zhangxuhong1024/wifi2can/hardware/out/wifi2can.pdf

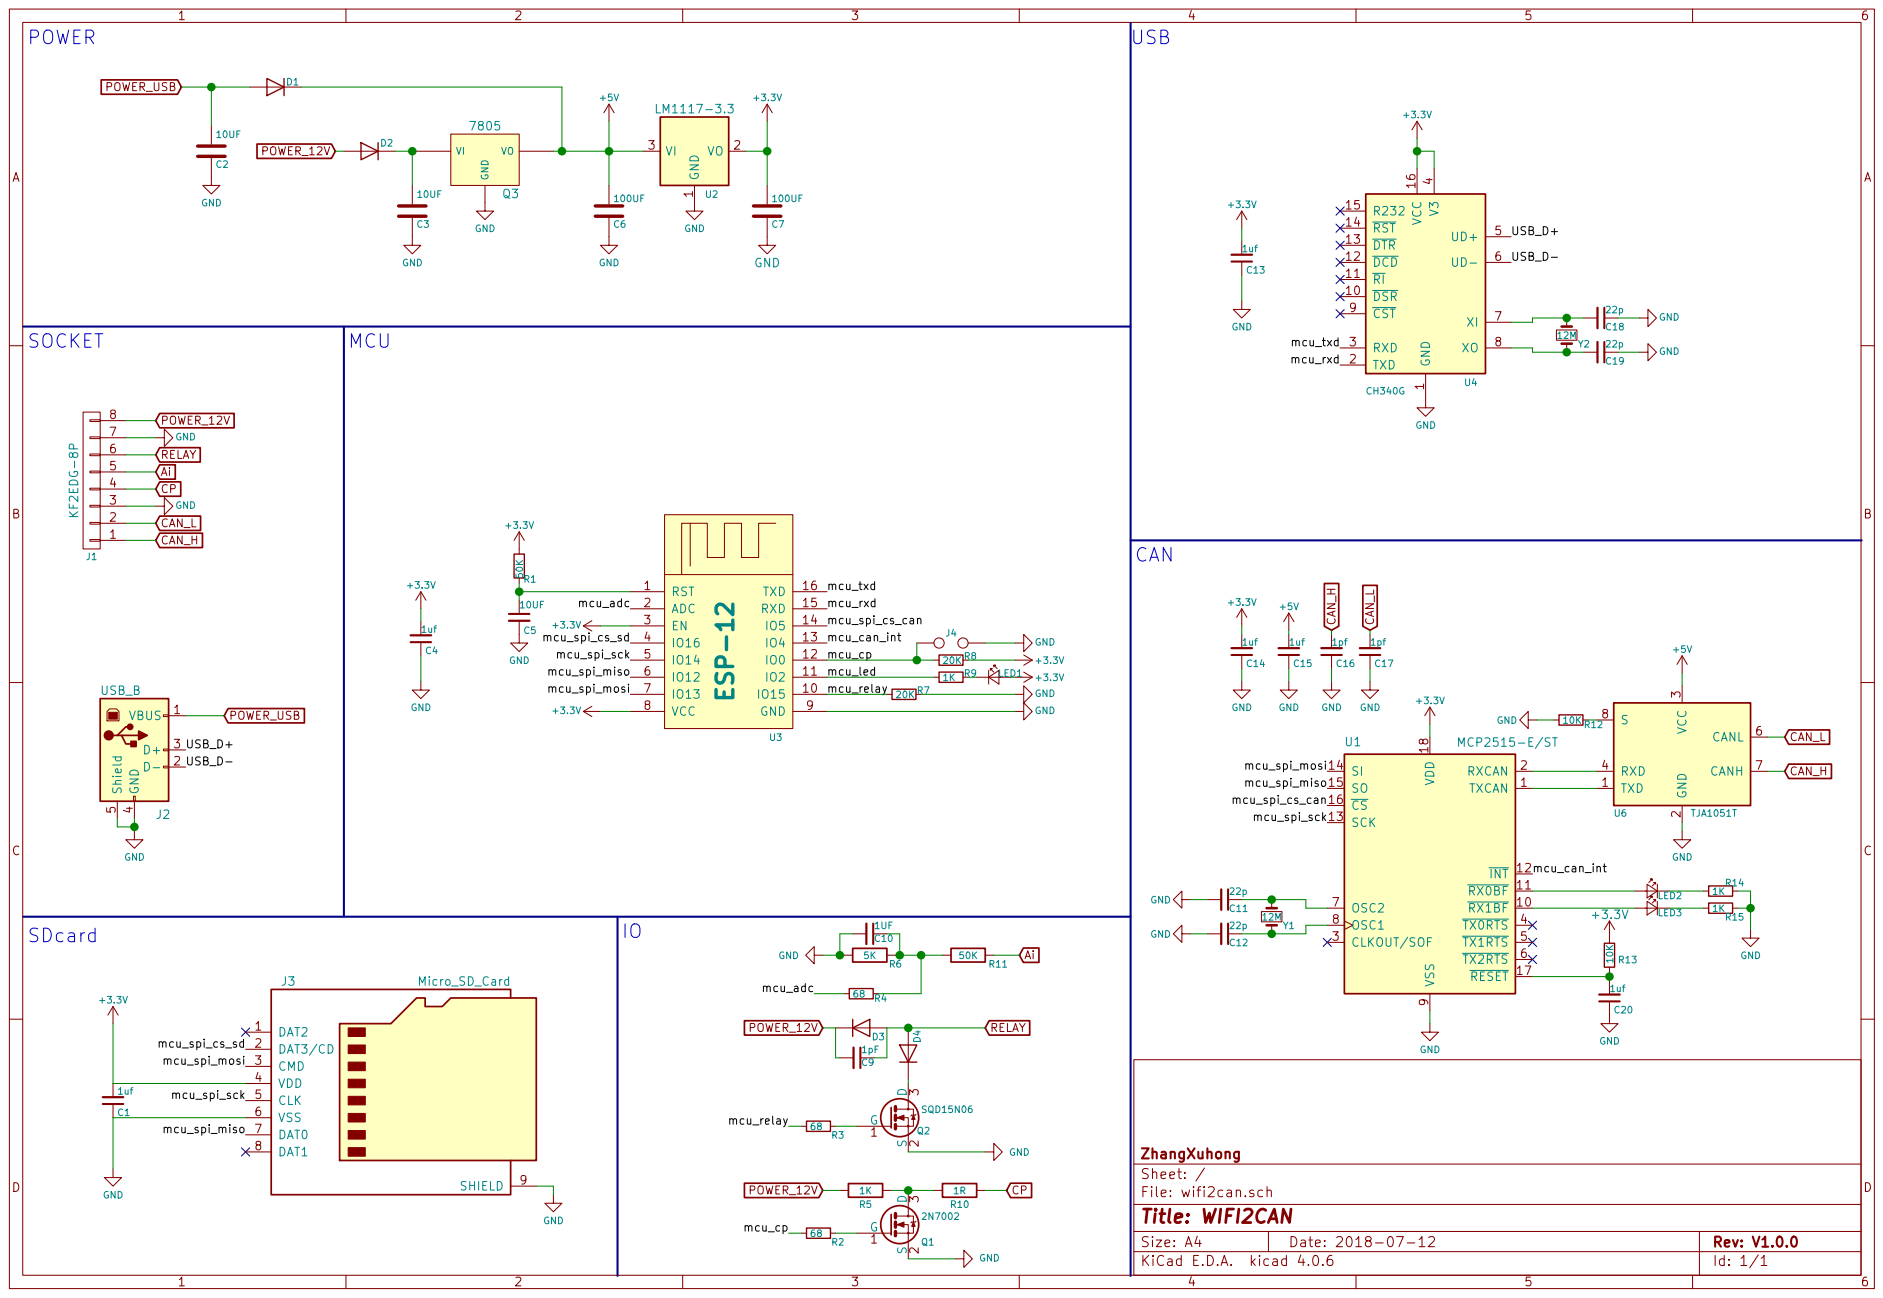
[picture p1: page 1]

1 VO 2 VI 3 U2 LM1117-3.3 RST 1 ADC 2 EN 3

4 UD+ 5 UD- 6 XI 7 XO 8 CST 9 DSR 10 RI 11 DCD 12 DTR 13 RST 14 R232 15 VCC 16 U4 CH340G GND

File: wifi2can.sch Sheet: / ZhangXuhong
