zhangxuhong1024/wifi2can/doc/外壳.pdf

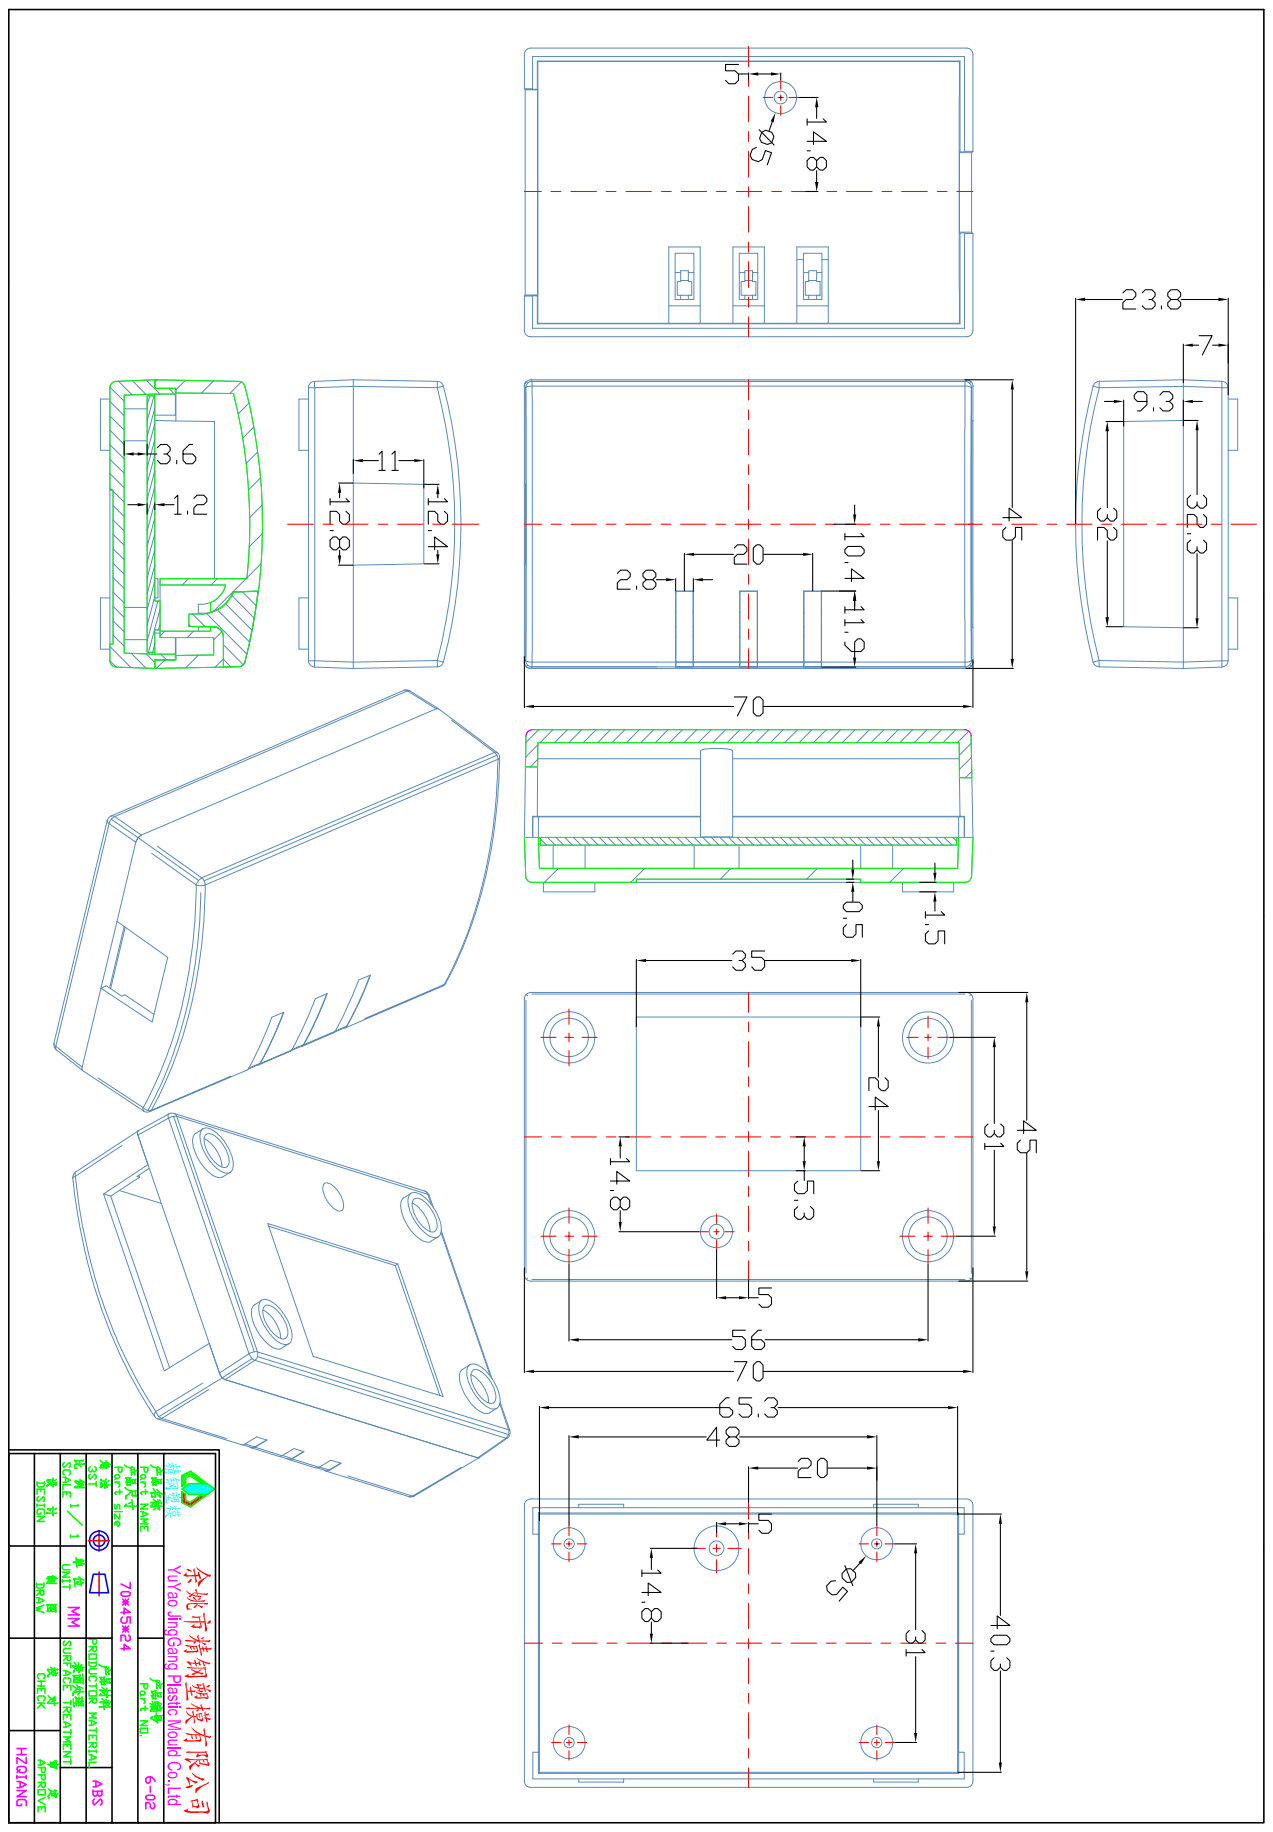
[picture p2: page 1]
