zhangxuhong1024/wifi2can/hardware/wifi2can.kicad_pcb

## KiCad design hardware/wifi2can.kicad_pcb (2018-11-23)

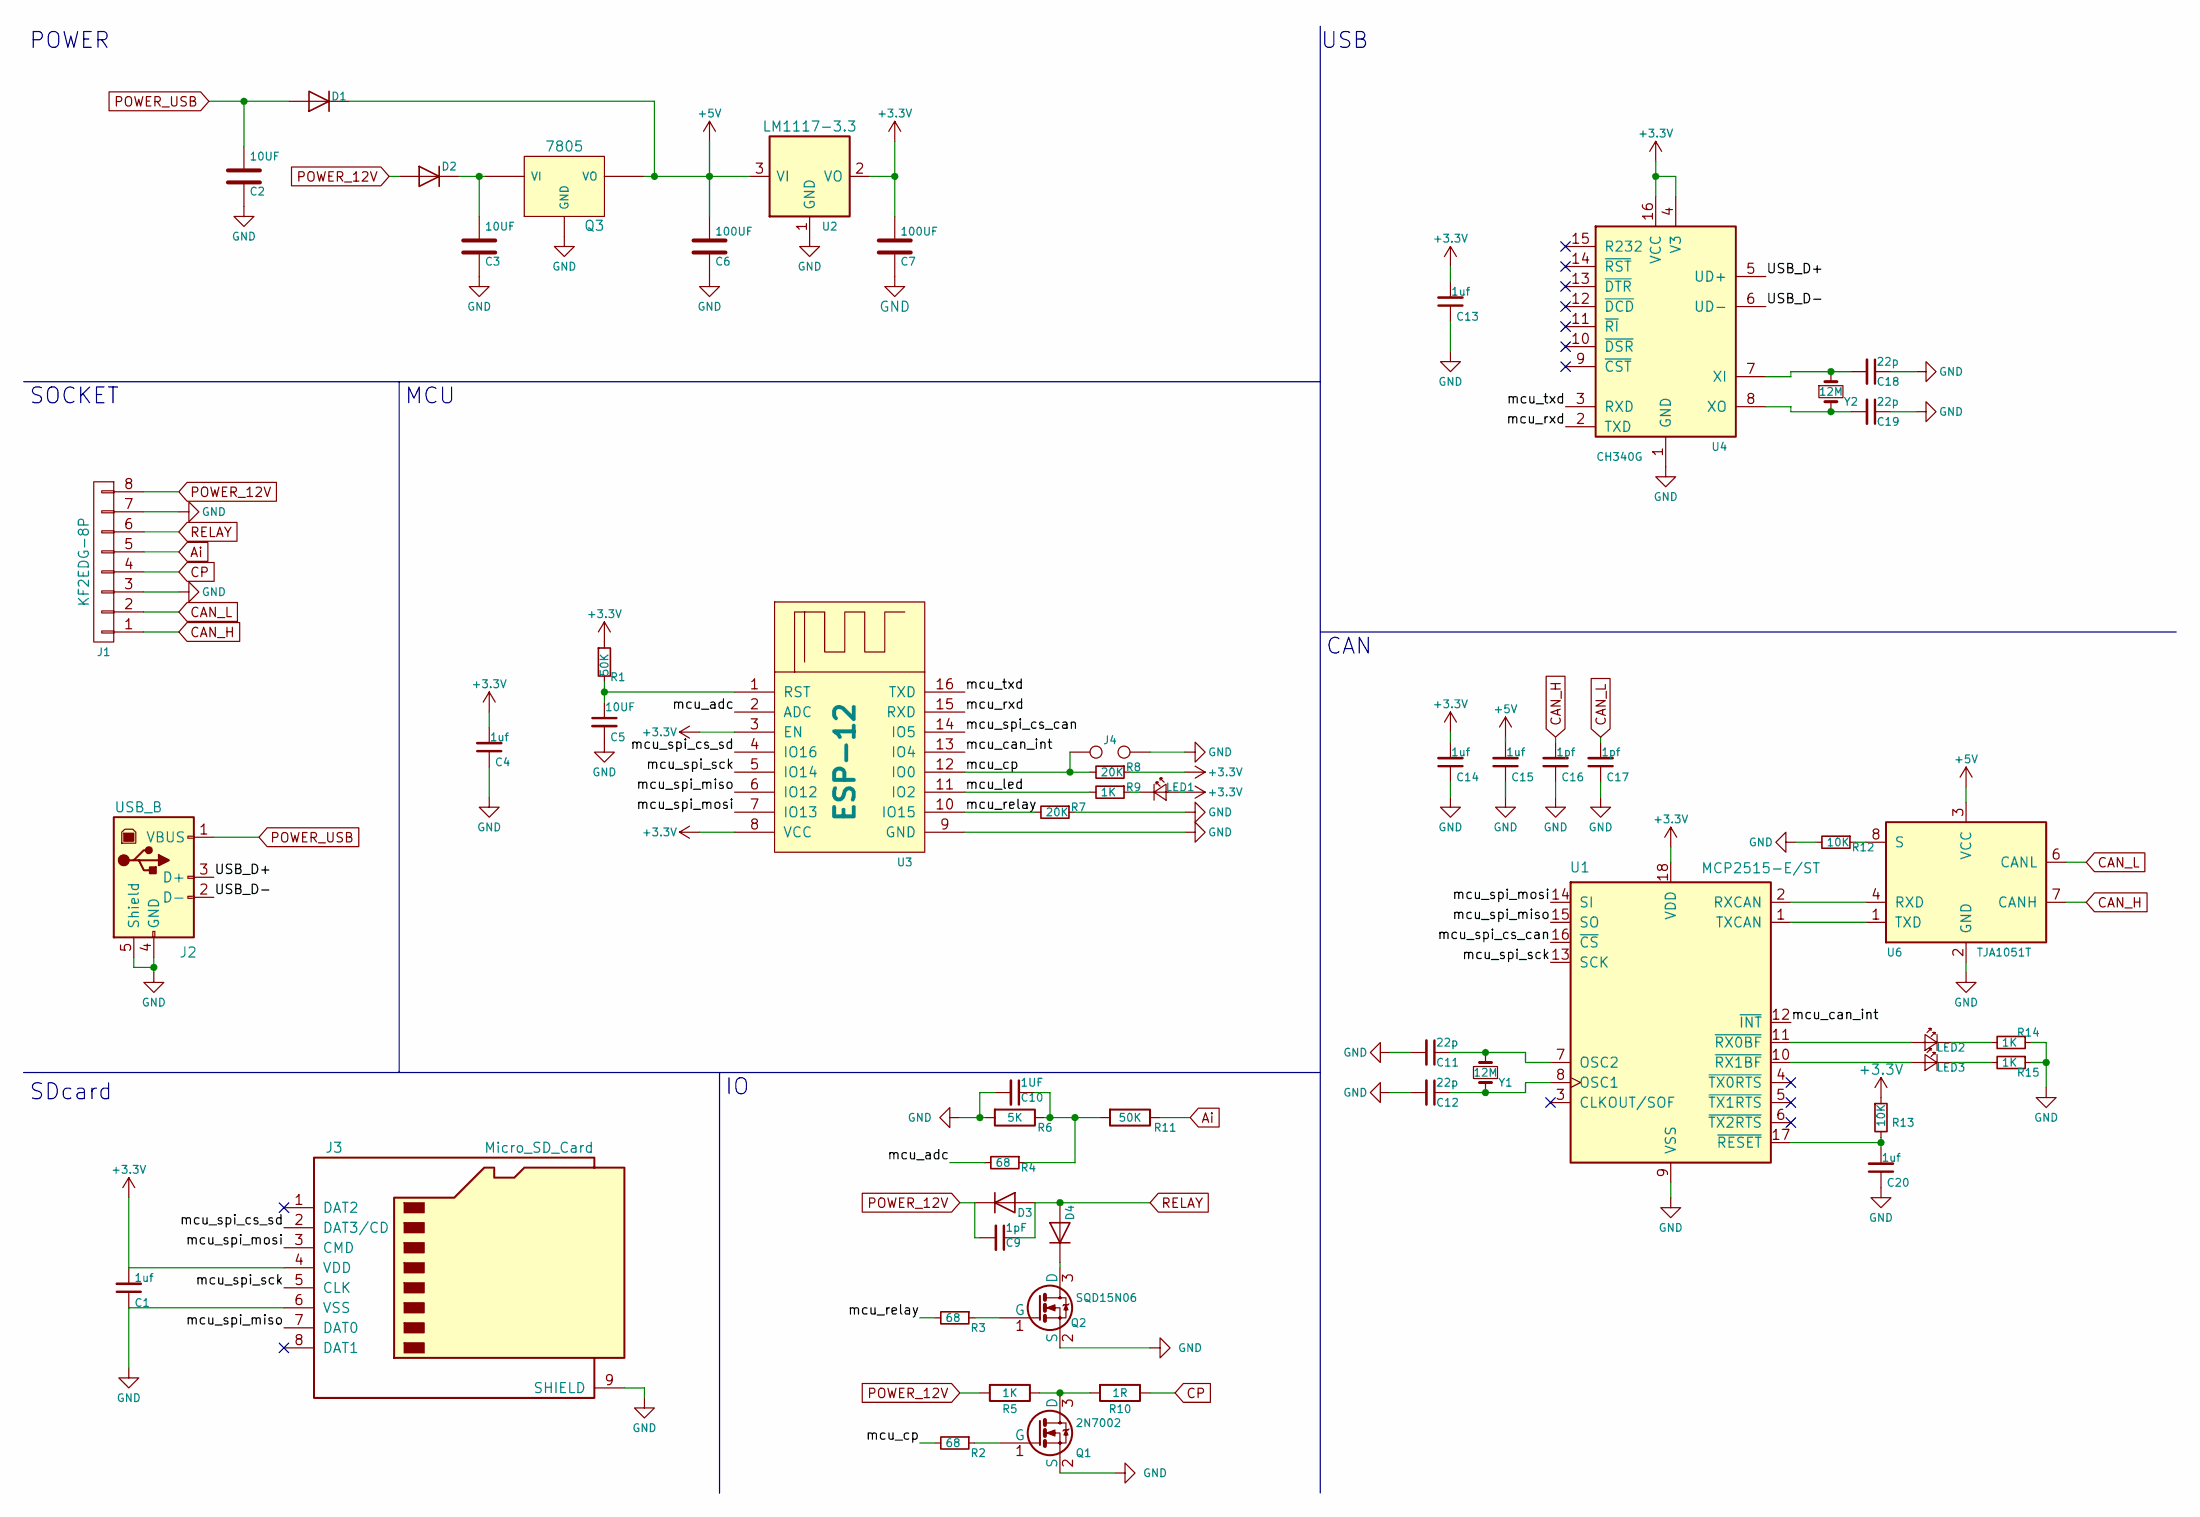
[picture p3: schematic wifi2can.sch]

Parts:
C1, C4, C13, C14, C15, C20: 1uf; C_0805
C2, C3, C5: 10UF; C_0805
C6, C7: 100UF; CP_Elec_8x6.7
C9: 1pF; C_0805
C10: 1UF; C_0805
C11, C12, C18, C19: 22p; C_0805
C16, C17: 1pf; C_0805
D1, D2, D3, D4: D; D_SMB_Handsoldering
J1: KF2EDG-8P; PhoenixContact_MC-G_08x3.81mm_Angled
J2: USB_B
J3: Micro_SD_Card; TF(Micro-SD)
J4: download; wifi2can_download
LED1, LED2, LED3: LED_Small; LED_1206
Q1: 2N7002; SOT-23
Q2: SQD15N06; TO-252-2Lead
Q3: 7805; 78m05
R1, R11: 50K; R_0805
R2, R3, R4: 68; R_0805
R5, R9, R14, R15: 1K; R_0805
R6: 5K; R_0805
R7, R8: 20K; R_0805
R10: 1R; R_0805
R12, R13: 10K; R_0805
U1: MCP2515-E/ST; SOIC-18W_7.5x11.6mm_Pitch1.27mm
U2: LM1117-3.3; SOT-223-3Lead_TabPin2
U3: ESP-12; ESP-12E_SMD
U4: CH340G; SOIC-16_3.9x9.9mm_Pitch1.27mm
U6: TJA1051T; SOIC-8_3.9x4.9mm_Pitch1.27mm
Y1, Y2: 12M; Crystal_SMD_5032-4pin_5.0x3.2mm

Connections:
+3V3: C1.2, C4.2, C7.1, C13.2, C14.2, J3.4 (VDD), LED1.2 (A), R1.1, R8.1, R13.1, U1.18 (VDD), U2.2 (VO), U3.3 (EN), U3.8 (VCC), U4.4 (V3), U4.16 (VCC)
+5V: C6.1, C15.2, D1.1 (K), Q3.VO, U2.3 (VI), U6.3 (VCC)
/USB_D+: J2.3 (D+), U4.5 (UD+)
/USB_D-: J2.2 (D-), U4.6 (UD-)
/mcu_adc: R4.2, U3.2 (ADC)
/mcu_can_int: U1.12 (~INT), U3.13 (IO4)
/mcu_cp: J4.1, R2.2, R8.2, U3.12 (IO0)
/mcu_led: R9.2, U3.11 (IO2)
/mcu_relay: R3.2, R7.2, U3.10 (IO15)
/mcu_rxd: U3.15 (RXD), U4.2 (TXD)
/mcu_spi_cs_can: U1.16 (~CS), U3.14 (IO5)
/mcu_spi_cs_sd: J3.2 (DAT3/CD), U3.4 (IO16)
/mcu_spi_miso: J3.7 (DAT0), U1.15 (SO), U3.6 (IO12)
/mcu_spi_mosi: J3.3 (CMD), U1.14 (SI), U3.7 (IO13)
/mcu_spi_sck: J3.5 (CLK), U1.13 (SCK), U3.5 (IO14)
/mcu_txd: U3.16 (TXD), U4.3 (RXD)
Ai: J1.5, R11.1
CAN_H: C16.2, J1.1, U6.7 (CANH)
CAN_L: C17.2, J1.2, U6.6 (CANL)
CP: J1.4, R10.1
GND: C1.1, C2.2, C3.2, C4.1, C5.2, C6.2, C7.2, C10.2, C11.2, C12.2, C13.1, C14.1, C15.1, C16.1, C17.1, C18.1, C19.1, C20.1, J1.3, J1.7, J2.4 (GND), J2.5 (Shield), J3.6 (VSS), J3.9 (SHIELD), J3.10, J4.2, Q1.2 (S), Q2.2 (S), Q3.GND, R6.2, R7.1, R12.2, R14.1, R15.1, U1.9 (VSS), U2.1 (GND), U3.9 (GND), U4.1 (GND), U6.2 (GND)
unnamed: C3.1, D2.1 (K), Q3.VI
unnamed: C5.1, R1.2, U3.1 (RST)
unnamed: C10.1, R4.1, R6.1, R11.2
unnamed: C11.1, U1.7 (OSC2), Y1.1
unnamed: C12.1, U1.8 (OSC1), Y1.2
unnamed: C18.2, U4.7 (XI), Y2.1
unnamed: C19.2, U4.8 (XO), Y2.2
unnamed: C20.2, R13.2, U1.17 (~RESET)
unnamed: D4.1 (K), Q2.3 (D)
unnamed: LED1.1 (K), R9.1
unnamed: LED2.1 (K), R14.2
unnamed: LED2.2 (A), U1.11 (~RX0BF)
unnamed: LED3.1 (K), R15.2
unnamed: LED3.2 (A), U1.10 (~RX1BF)
unnamed: Q1.1 (G), R2.1
unnamed: Q1.3 (D), R5.1, R10.2
unnamed: Q2.1 (G), R3.1
unnamed: R12.1, U6.8 (S)
unnamed: U1.1 (TXCAN), U6.1 (TXD)
unnamed: U1.2 (RXCAN), U6.4 (RXD)
POWER_12V: C9.2, D2.2 (A), D3.1 (K), J1.8, R5.2
POWER_USB: C2.1, D1.2 (A), J2.1 (VBUS)
RELAY: C9.1, D3.2 (A), D4.2 (A), J1.6

Notes on the sheet:
USB
POWER
SOCKET
MCU
CAN
SDcard

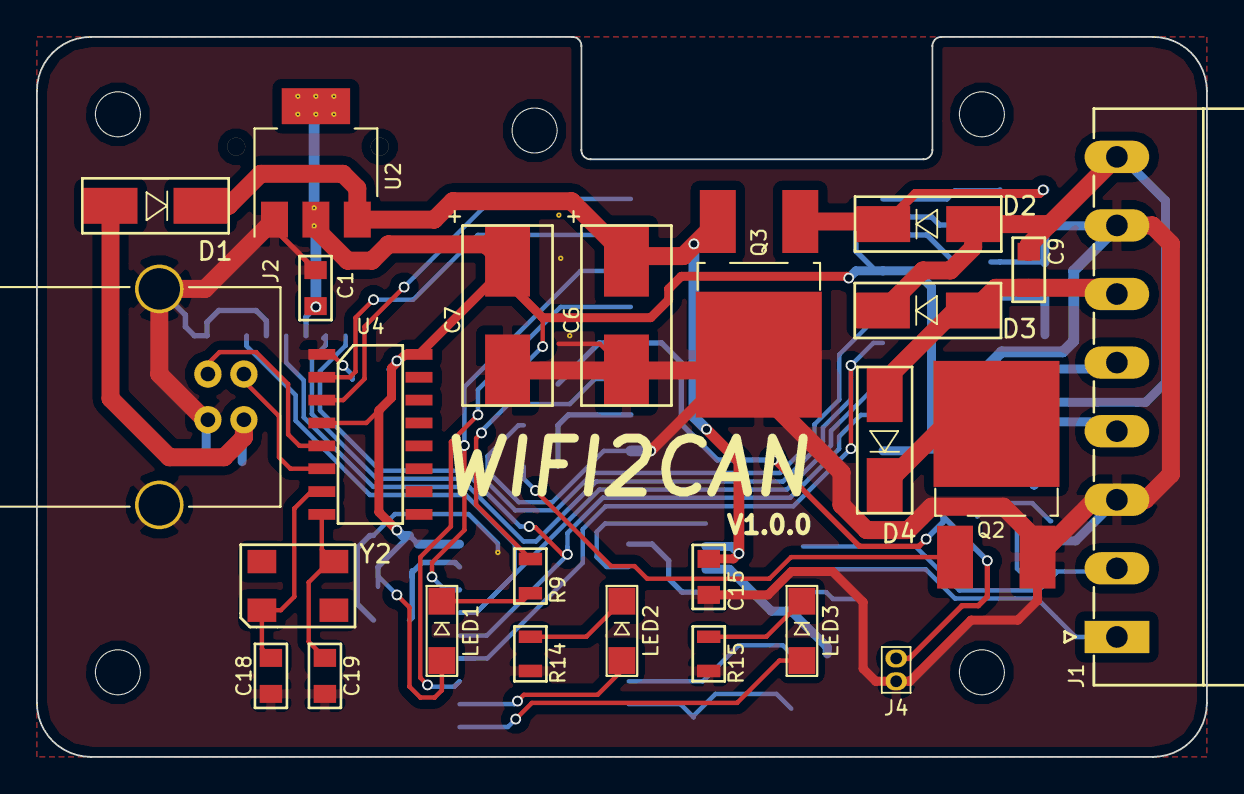
[picture p4: board wifi2can.kicad_pcb from above]

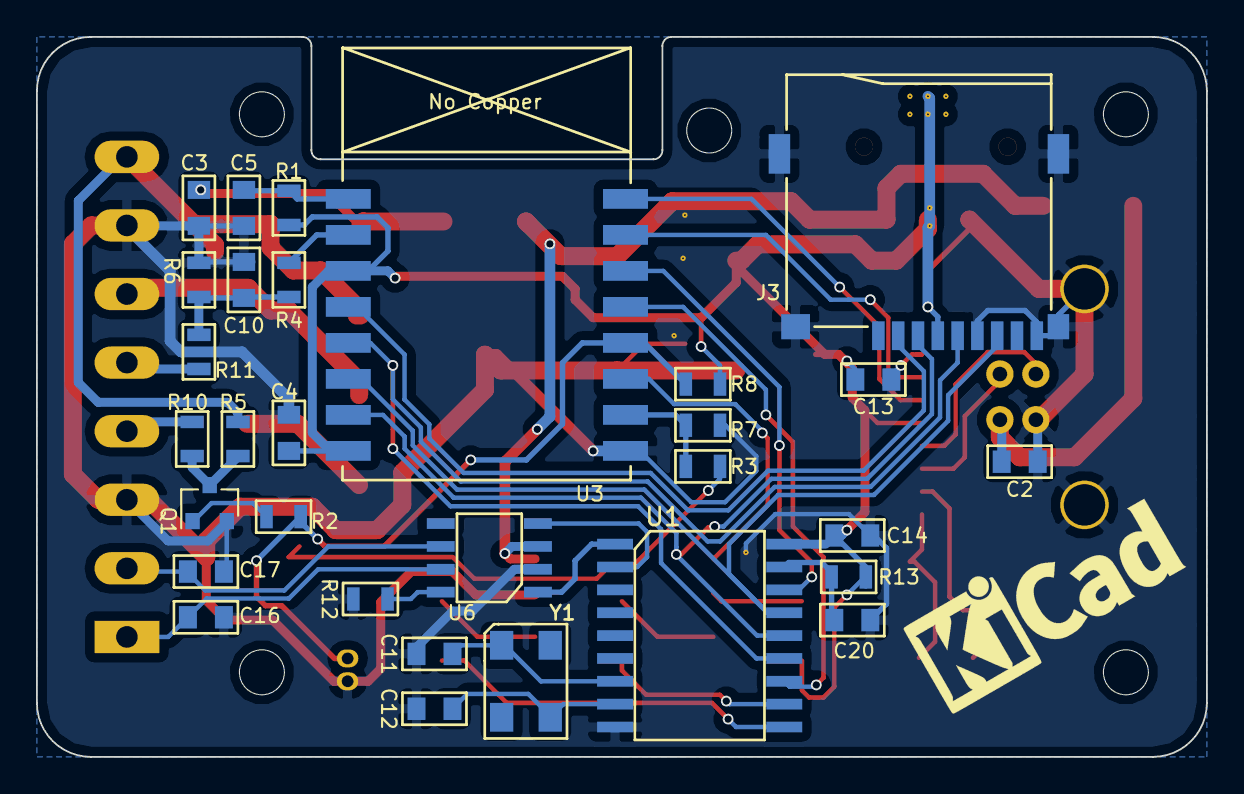
[picture p5: board wifi2can.kicad_pcb from below]

Board: 2 copper layers, 65.0 x 40.0 mm, 55 parts (30 on the bottom side), 44 nets.
