zhangxuhong1024/wifi2can/(commit log)

2018-11-23 Add documents.
    Add 增加文档资料
2018-11-23 Add hardware.
    Add 增加硬件设计资料。
    Doc Kicad_V4.0.7
    [wifi2can-B.Cu.gbr, wifi2can-B.Mask.gbr, wifi2can-B.SilkS.gbr, wifi2can-Dwgs.User.gbr, wifi2can-Edge.Cuts.gbr, wifi2can-F.Cu.gbr, wifi2can-F.Mask.gbr, wifi2can-F.SilkS.gbr]
2018-11-23 Add program
    Add MicroPython软件
